adamdanishj30/washer-pdm/docs/hardware_guides/diagrams/washer_electronics_layout_diagram.jpg

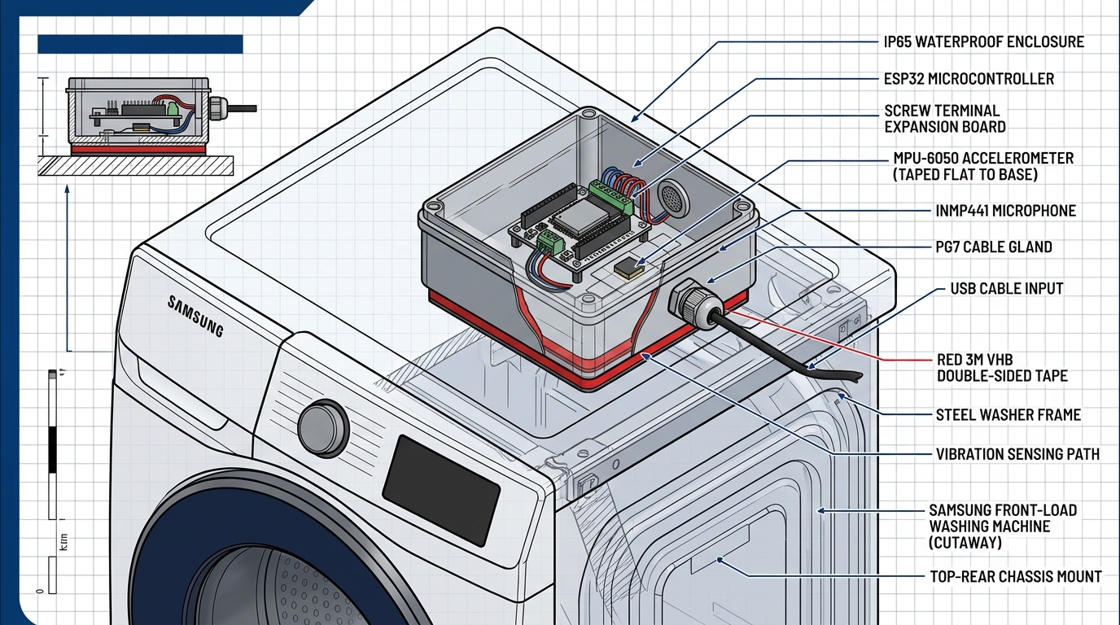
docs/hardware_guides/diagrams/washer_electronics_layout_diagram.jpg
