adamdanishj30/washer-pdm/docs/hardware_guides/diagrams/annotated_inmp441_pinout.png

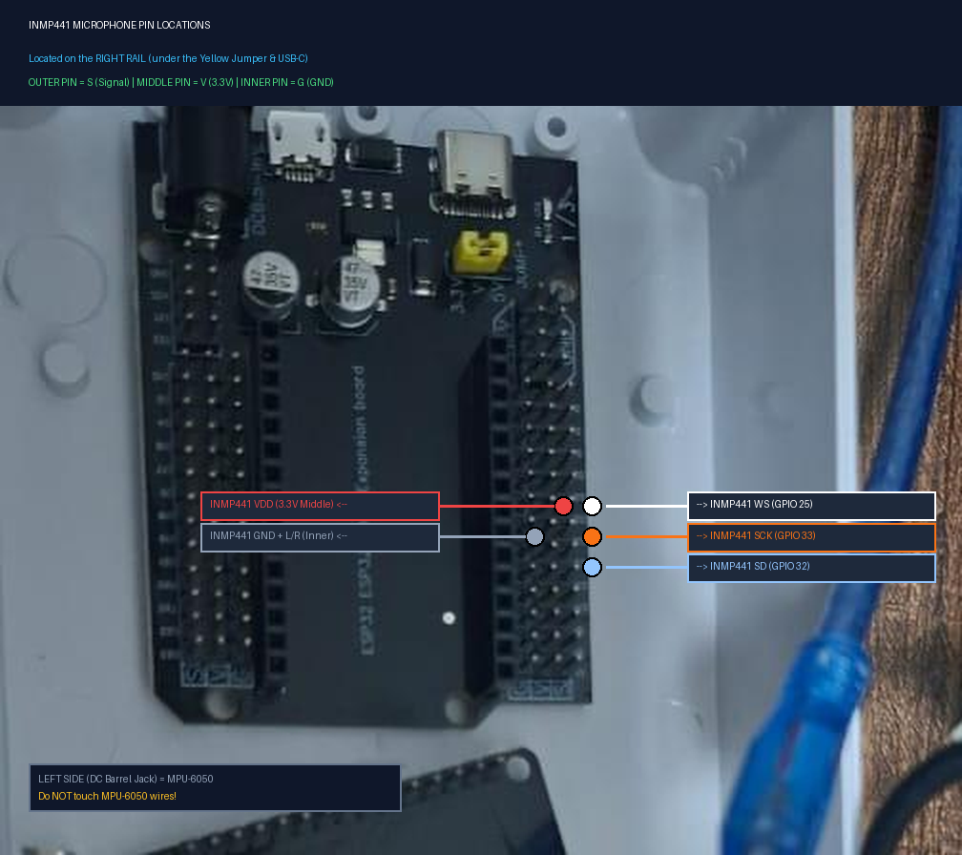
docs/hardware_guides/diagrams/annotated_inmp441_pinout.png
