adamdanishj30/washer-pdm/ml/models/loco_report.md

# Leave-one-cycle-out evaluation (nested, healthy baseline + injected faults)

Generated by `py ml/train_unsupervised_pdm.py`. Every number below comes from a model that never saw the cycle it was tested on (threshold and percentile tables included).

## Data caveats

- 8 healthy cycles, 6,461 windows of 5 s; effective sample size for cycle-level claims is 8, not 6,461 (consecutive windows are strongly correlated).
- SmartThings phase labels present on 0% of windows -> the model is NOT phase-conditioned (one pooled model for the whole cycle).
- Power unusable in 5/8 cycles (wash_cycle_2026-10-11_1019, wash_cycle_2026-10-12_1019, wash_cycle_2026-10-15_1020, wash_cycle_2026-10-15_morning, wash_cycle_2026-10-17_0835) -> power features excluded.
- Accelerometer gravity vector moved by up to 0.76 m/s^2 between cycles (sensor re-mounted/tilted) -> only orientation-independent vibration features are used.
- Legacy data = one instantaneous accel sample + one 8 ms audio RMS per 5 s. Impulsive (bearing) and spectral features cannot be computed; collect firmware-07 cycles.

## Healthy cycles: false alarms

| model | false-alarm cycles | 95% upper bound on false-alarm rate | healthy windows red | amber |
|---|---|---|---|---|
| mahalanobis | 0 / 8 | 31% | 0.3% | 4.88% |
| iforest | 0 / 8 | 31% | 0.49% | 4.59% |
| ocsvm | 1 / 8 | 47% | 0.35% | 3.77% |

The upper bound is wide because there are only a few cycles; it narrows only with more healthy cycles (about 30 alarm-free cycles are needed to claim < 10%).

## Injected faults: clean detection rate by severity

Clean detection = cycle alarm (overall model OR an indicator: 10-min EWMA of calibrated z above its threshold) after the fault started AND no alarm before it. Faults start halfway through the held-out cycle and ramp in over 3 minutes.

### mahalanobis

| fault | unit | sev 1 | sev 2 | sev 3 | sev 4 | min detectable |
|---|---|---|---|---|---|---|
| acoustic_rise | x RMS | 0.1: 12% (26.5 min) | 0.25: 12% (12.6 min) | 0.5: 25% (21.0 min) | 1: 88% (15.7 min) | 1.0 |
| vibration_rise | m/s2 RMS | 0.02: 0% | 0.05: 0% | 0.1: 0% | 0.2: 0% | not reached |

### iforest

| fault | unit | sev 1 | sev 2 | sev 3 | sev 4 | min detectable |
|---|---|---|---|---|---|---|
| acoustic_rise | x RMS | 0.1: 12% (26.5 min) | 0.25: 12% (12.6 min) | 0.5: 25% (21.0 min) | 1: 88% (15.7 min) | 1.0 |
| vibration_rise | m/s2 RMS | 0.02: 0% | 0.05: 0% | 0.1: 0% | 0.2: 0% | not reached |

### ocsvm

| fault | unit | sev 1 | sev 2 | sev 3 | sev 4 | min detectable |
|---|---|---|---|---|---|---|
| acoustic_rise | x RMS | 0.1: 12% (6.3 min) | 0.25: 12% (5.1 min) | 0.5: 25% (19.7 min) | 1: 88% (15.7 min) | 1.0 |
| vibration_rise | m/s2 RMS | 0.02: 12% (27.5 min) | 0.05: 0% | 0.1: 0% | 0.2: 0% | not reached |

## What these results do and do not show

- They show the false-alarm behaviour on the recorded healthy cycles and how large a sustained, physically-parameterised change must be before the pipeline reliably flags it.
- They do NOT show that real bearing or damper faults would be detected: injected faults are models (see `ml/fault_injection.py` for the limits), and no real fault data exists yet.
- Component labels (acoustic / vibration / power indicators) say where a deviation is, not which part failed. No remaining-useful-life estimate is made: that needs real degradation data.
