adamdanishj30/washer-pdm/ml/outputs/fw07_loco_2026-10-31/loco_report.md

# Leave-one-cycle-out evaluation (nested, healthy baseline + injected faults)

Generated by `py ml/train_unsupervised_pdm.py`. Every number below comes from a model that never saw the cycle it was tested on (threshold and percentile tables included).

## Data caveats

- 9 healthy cycles, 7,443 windows of 5 s; effective sample size for cycle-level claims is 9, not 7,443 (consecutive windows are strongly correlated).
- SmartThings phase labels present on 0% of windows -> the model is NOT phase-conditioned (one pooled model for the whole cycle).
- Accelerometer gravity vector moved by up to 15.46 m/s^2 between cycles (sensor re-mounted/tilted) -> only orientation-independent vibration features are used.

## Healthy cycles: false alarms

| model | false-alarm cycles | 95% upper bound on false-alarm rate | healthy windows red | amber |
|---|---|---|---|---|
| mahalanobis | 2 / 9 | 55% | 0.26% | 5.11% |
| iforest | 2 / 9 | 55% | 2.44% | 1.57% |
| ocsvm | 2 / 9 | 55% | 0.11% | 4.42% |

The upper bound is wide because there are only a few cycles; it narrows only with more healthy cycles (about 30 alarm-free cycles are needed to claim < 10%).

## Injected faults: clean detection rate by severity

Clean detection = cycle alarm (overall model OR an indicator: 10-min EWMA of calibrated z above its threshold) after the fault started AND no alarm before it. Faults start halfway through the held-out cycle and ramp in over 3 minutes.

### mahalanobis

| fault | unit | sev 1 | sev 2 | sev 3 | sev 4 | min detectable |
|---|---|---|---|---|---|---|
| power_drag | W | 5: 11% (36.2 min) | 10: 11% (36.2 min) | 20: 11% (36.2 min) | 40: 11% (36.2 min) | not reached |
| bearing_impulsive | x hp RMS | 0.1: 11% (36.2 min) | 0.25: 11% (36.2 min) | 0.5: 44% (19.7 min) | 1: 78% (7.5 min) | 1.0 |
| suspension_rocking | m/s2 RMS | 0.01: 11% (35.8 min) | 0.02: 11% (34.5 min) | 0.05: 11% (20.2 min) | 0.1: 44% (37.3 min) | not reached |
| imbalance_1x | m/s2 RMS | 0.02: 11% (36.2 min) | 0.05: 11% (33.0 min) | 0.1: 11% (18.9 min) | 0.2: 44% (26.2 min) | not reached |

### iforest

| fault | unit | sev 1 | sev 2 | sev 3 | sev 4 | min detectable |
|---|---|---|---|---|---|---|
| power_drag | W | 5: 11% (35.3 min) | 10: 11% (35.3 min) | 20: 11% (35.3 min) | 40: 11% (35.3 min) | not reached |
| bearing_impulsive | x hp RMS | 0.1: 11% (35.2 min) | 0.25: 11% (35.1 min) | 0.5: 44% (19.7 min) | 1: 78% (7.5 min) | 1.0 |
| suspension_rocking | m/s2 RMS | 0.01: 11% (35.2 min) | 0.02: 11% (34.5 min) | 0.05: 11% (20.2 min) | 0.1: 44% (37.3 min) | not reached |
| imbalance_1x | m/s2 RMS | 0.02: 11% (35.2 min) | 0.05: 11% (33.0 min) | 0.1: 11% (18.9 min) | 0.2: 44% (26.2 min) | not reached |

### ocsvm

| fault | unit | sev 1 | sev 2 | sev 3 | sev 4 | min detectable |
|---|---|---|---|---|---|---|
| power_drag | W | 5: 11% (36.2 min) | 10: 11% (36.2 min) | 20: 11% (36.2 min) | 40: 11% (36.2 min) | not reached |
| bearing_impulsive | x hp RMS | 0.1: 11% (36.2 min) | 0.25: 11% (36.2 min) | 0.5: 44% (19.7 min) | 1: 78% (7.5 min) | 1.0 |
| suspension_rocking | m/s2 RMS | 0.01: 11% (35.8 min) | 0.02: 11% (34.5 min) | 0.05: 11% (20.2 min) | 0.1: 44% (37.3 min) | not reached |
| imbalance_1x | m/s2 RMS | 0.02: 11% (36.2 min) | 0.05: 11% (33.0 min) | 0.1: 11% (18.9 min) | 0.2: 44% (26.2 min) | not reached |

## What these results do and do not show

- They show the false-alarm behaviour on the recorded healthy cycles and how large a sustained, physically-parameterised change must be before the pipeline reliably flags it.
- They do NOT show that real bearing or damper faults would be detected: injected faults are models (see `ml/fault_injection.py` for the limits), and no real fault data exists yet.
- Component labels (acoustic / vibration / power indicators) say where a deviation is, not which part failed. No remaining-useful-life estimate is made: that needs real degradation data.
