adamdanishj30/washer-pdm/docs/hardware_guides/diagrams/mic_mounting_visual_guide.png

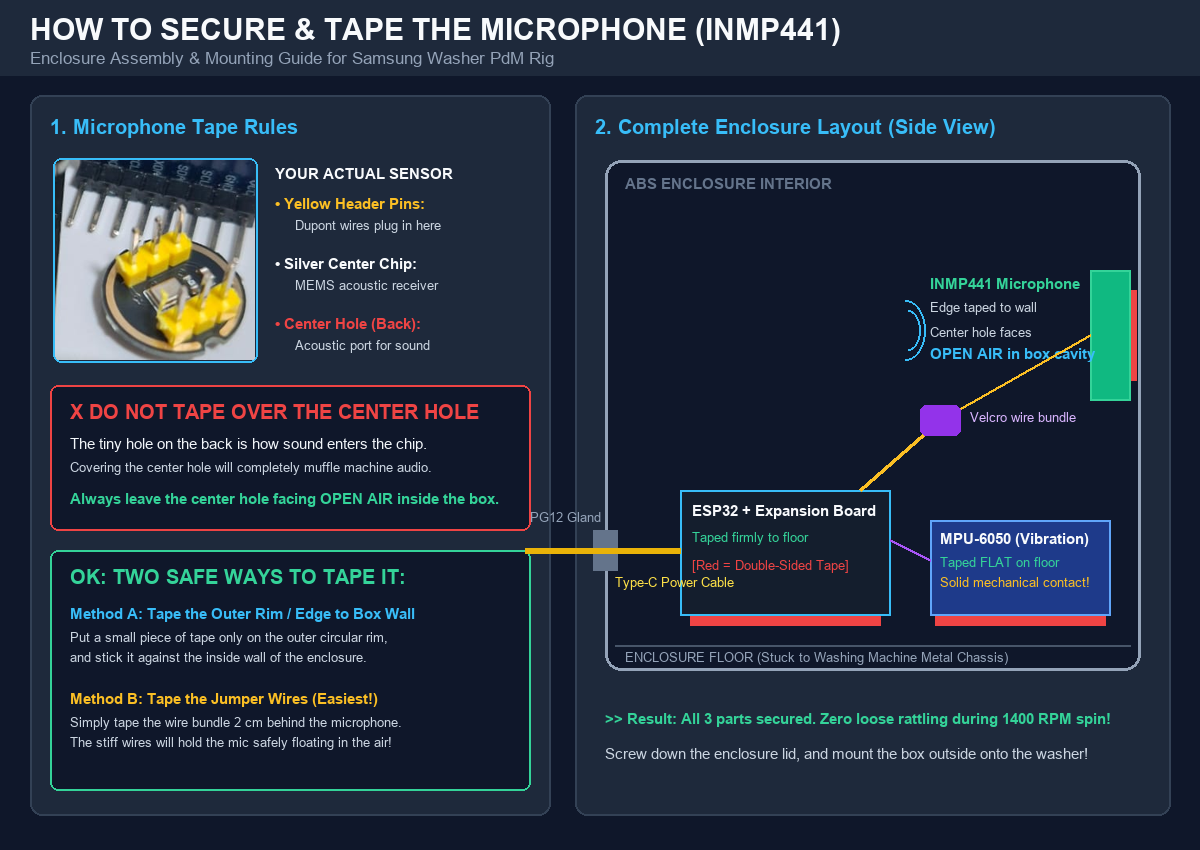
docs/hardware_guides/diagrams/mic_mounting_visual_guide.png
