adamdanishj30/washer-pdm/docs/hardware_guides/diagrams/mic_sides_clarity_guide.png

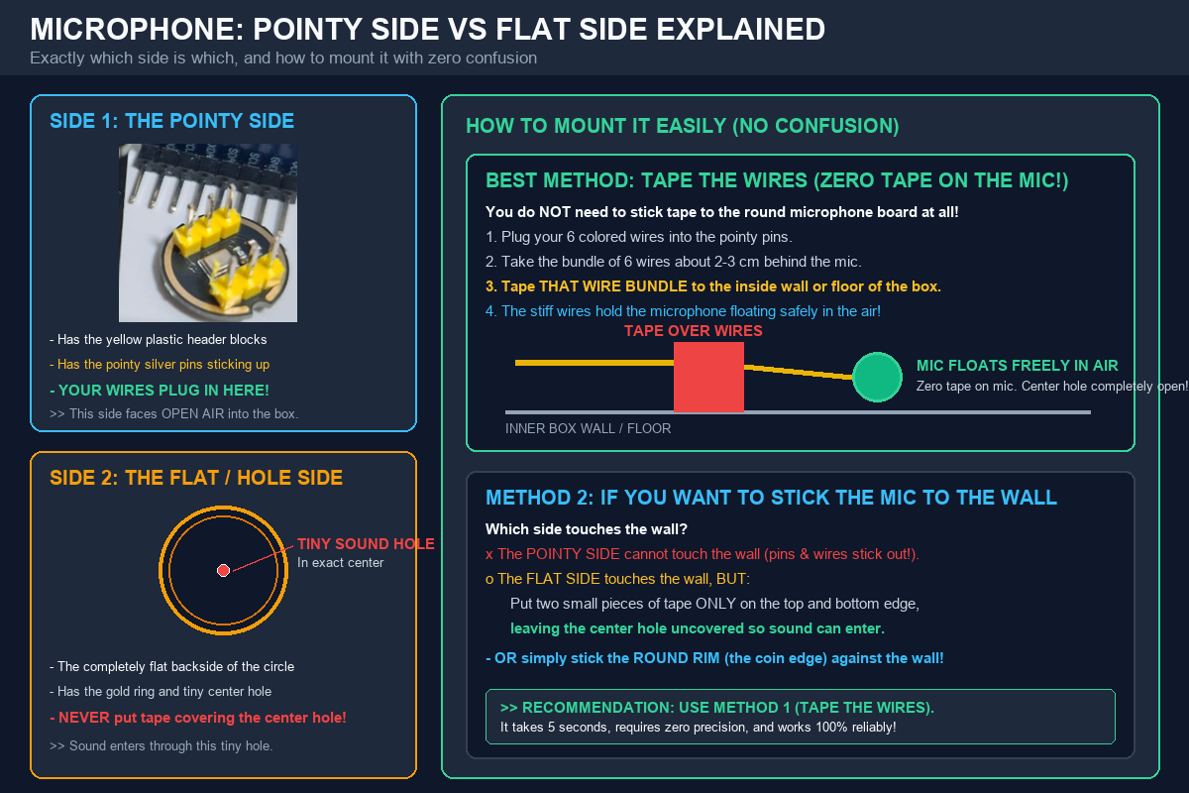
docs/hardware_guides/diagrams/mic_sides_clarity_guide.png
