adamdanishj30/washer-pdm/data/testing_data/wash_cycle_1009.csv

timestamp_ms | accel_x | accel_y | accel_z | audio_rms | power_w | phase | load_class
10278 | -1.78 | 2.20 | -9.18 | 62.3 | 0.0 | weightSensing | MEDIUM
15296 | -1.75 | 2.23 | -9.21 | 120.2 | 0.0 | weightSensing | MEDIUM
20386 | -1.75 | 2.23 | -9.17 | 297.5 | 0.0 | weightSensing | MEDIUM
25417 | -1.78 | 2.20 | -9.21 | 82.7 | 0.0 | weightSensing | MEDIUM
30506 | -1.70 | 2.27 | -9.28 | 407.4 | 0.0 | spin | MEDIUM
35510 | -1.80 | 2.22 | -9.17 | 203.6 | 0.0 | weightSensing | MEDIUM
40659 | -1.71 | 2.17 | -9.21 | 275.1 | 0.0 | weightSensing | MEDIUM
45693 | -1.71 | 2.29 | -9.14 | 80.1 | 0.0 | weightSensing | MEDIUM
50837 | -1.73 | 2.18 | -9.15 | 81.2 | 0.0 | weightSensing | MEDIUM
55851 | -1.75 | 2.24 | -9.20 | 193.9 | 0.0 | weightSensing | MEDIUM
60970 | -1.74 | 2.24 | -9.07 | 169.5 | 0.0 | weightSensing | MEDIUM
65990 | -1.77 | 2.21 | -9.12 | 180.2 | 0.0 | weightSensing | MEDIUM
71144 | -1.74 | 2.17 | -9.21 | 161.5 | 0.0 | weightSensing | MEDIUM
76156 | -1.72 | 2.22 | -9.09 | 57.5 | 0.0 | weightSensing | MEDIUM
81471 | -1.73 | 2.22 | -9.19 | 101.8 | 0.0 | weightSensing | MEDIUM
123113 | -1.76 | 2.15 | -9.15 | 295.1 | 0.0 | wash | MEDIUM
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
