adamdanishj30/washer-pdm/data/testing_data/wash_cycle_2026-10-11_1020.csv

timestamp_ms | accel_x | accel_y | accel_z | audio_rms | power_w
10681 | -1.51 | 2.62 | -9.1 | 157.7 | 0.0
15701 | -1.54 | 2.61 | -9.03 | 90.0 | 0.0
20822 | -1.57 | 2.59 | -9.06 | 234.6 | 0.0
25823 | -1.54 | 2.66 | -9.1 | 105.9 | 0.0
31506 | -1.56 | 2.61 | -9.13 | 156.4 | 0.0
36904 | -1.58 | 2.63 | -9.12 | 21.3 | 0.0
42076 | -1.55 | 2.59 | -9.13 | 216.5 | 0.0
53925 | -1.56 | 2.62 | -9.14 | 289.1 | 0.0
65528 | -1.57 | 2.6 | -9.05 | 247.6 | 0.0
70933 | -1.57 | 2.66 | -9.13 | 32.6 | 0.0
