adamdanishj30/washer-pdm/data/testing_data/wash_cycle_2026-10-12_0800.csv

timestamp_ms | accel_x | accel_y | accel_z | audio_rms | power_w | phase | load_class
9744 | -1.37 | 2.55 | -9.09 | 79.4 | 0.0 | weightSensing | MEDIUM
16463 | -1.32 | 2.57 | -9.19 | 69.5 | 0.0 | weightSensing | MEDIUM
21509 | -1.40 | 2.56 | -9.18 | 144.6 | 0.0 | weightSensing | MEDIUM
26557 | -1.37 | 2.58 | -9.14 | 87.0 | 0.0 | weightSensing | MEDIUM
31591 | -1.34 | 2.61 | -9.17 | 99.9 | 0.0 | weightSensing | MEDIUM
36616 | -1.35 | 2.58 | -9.18 | 104.5 | 0.0 | weightSensing | MEDIUM
41692 | -1.34 | 2.56 | -9.13 | 71.0 | 0.0 | weightSensing | MEDIUM
46729 | -1.35 | 2.60 | -9.14 | 102.6 | 0.0 | weightSensing | MEDIUM
51816 | -1.36 | 2.56 | -9.16 | 169.6 | 0.0 | weightSensing | MEDIUM
56821 | -1.35 | 2.60 | -9.17 | 59.2 | 0.0 | weightSensing | MEDIUM
61893 | -1.32 | 2.60 | -9.15 | 82.6 | 0.0 | weightSensing | MEDIUM
66905 | -1.35 | 2.60 | -9.16 | 77.1 | 0.0 | weightSensing | MEDIUM
72050 | -1.35 | 2.58 | -9.18 | 110.6 | 0.0 | weightSensing | MEDIUM
77091 | -1.34 | 2.60 | -9.13 | 150.2 | 0.0 | weightSensing | MEDIUM
82144 | -1.35 | 2.58 | -9.10 | 143.3 | 0.0 | weightSensing | MEDIUM
87180 | -1.36 | 2.58 | -9.17 | 162.5 | 0.0 | weightSensing | MEDIUM
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
