adamdanishj30/washer-pdm/data/testing_data/wash_cycle_2026-10-12_1009.csv

timestamp_ms | accel_x | accel_y | accel_z | audio_rms | power_w
10278 | -1.78 | 2.20 | -9.18 | 62.3 | 0.0
15296 | -1.75 | 2.23 | -9.21 | 120.2 | 0.0
20386 | -1.75 | 2.23 | -9.17 | 297.5 | 0.0
25417 | -1.78 | 2.20 | -9.21 | 82.7 | 0.0
30506 | -1.70 | 2.27 | -9.28 | 407.4 | 0.0
35510 | -1.80 | 2.22 | -9.17 | 203.6 | 0.0
40659 | -1.71 | 2.17 | -9.21 | 275.1 | 0.0
45693 | -1.71 | 2.29 | -9.14 | 80.1 | 0.0
50837 | -1.73 | 2.18 | -9.15 | 81.2 | 0.0
55851 | -1.75 | 2.24 | -9.20 | 193.9 | 0.0
60970 | -1.74 | 2.24 | -9.07 | 169.5 | 0.0
65990 | -1.77 | 2.21 | -9.12 | 180.2 | 0.0
71144 | -1.74 | 2.17 | -9.21 | 161.5 | 0.0
76156 | -1.72 | 2.22 | -9.09 | 57.5 | 0.0
81471 | -1.73 | 2.22 | -9.19 | 101.8 | 0.0
123113 | -1.76 | 2.15 | -9.15 | 295.1 | 0.0
128122 | -1.78 | 2.17 | -9.21 | 71.7 | 0.0
133132 | -1.75 | 2.19 | -9.16 | 164.2 | 0.0
138133 | -1.75 | 2.14 | -9.16 | 91.5 | 0.0
148584 | -1.71 | 2.16 | -9.19 | 42.1 | 0.0
153621 | -1.72 | 2.14 | -9.11 | 139.7 | 0.0
158796 | -1.71 | 2.20 | -9.19 | 200.7 | 0.0
163818 | -1.76 | 2.13 | -9.10 | 123.3 | 0.0
172631 | -1.72 | 2.18 | -9.18 | 38.7 | 0.0
177681 | -1.75 | 2.22 | -9.17 | 128.8 | 0.0
235398 | -1.76 | 2.17 | -9.21 | 46.3 | 0.0
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
