adamdanishj30/washer-pdm/generate_proposal_pdf.py

import os
import subprocess
import sys
import base64

def get_base64_image(path):
    if os.path.exists(path):
        with open(path, "rb") as f:
            ext = os.path.splitext(path)[1].lower().replace('.', '')
            if ext == 'jpg': ext = 'jpeg'
            return f"data:image/{ext};base64," + base64.b64encode(f.read()).decode('utf-8')
    return None

def main():
    base_dir = os.path.dirname(os.path.abspath(__file__))
    html_path = os.path.join(base_dir, "proposal_presentation.html")
    pdf_path = os.path.join(base_dir, "PROPOSAL_AcuVibe_PdM_Township_of_Tomorrow.pdf")

    # Load images if available
    img_layout = get_base64_image(os.path.join(base_dir, "washer_electronics_layout_diagram.jpg"))
    img_prototype = get_base64_image(os.path.join(base_dir, "image", "items.jpeg"))
    img_pinout = get_base64_image(os.path.join(base_dir, "annotated_inmp441_pinout.png"))

    html_content = f"""<!DOCTYPE html>
<html lang="en">
<head>
<meta charset="UTF-8">
<title>AcuVibe PdM - Sime Darby Property Hackathon Proposal</title>
<style>
  @import url('https://fonts.googleapis.com/css2?family=Plus+Jakarta+Sans:wght@300;400;500;600;700;800&family=JetBrains+Mono:wght@400;500;600&display=swap');

  @page {{
    size: A4;
    margin: 14mm 14mm 14mm 14mm;
  }}

  * {{
    box-sizing: border-box;
    -webkit-print-color-adjust: exact !important;
    print-color-adjust: exact !important;
  }}

  body {{
    font-family: 'Plus Jakarta Sans', -apple-system, BlinkMacSystemFont, "Segoe UI", Roboto, sans-serif;
    color: #1e293b;
    background-color: #ffffff;
    line-height: 1.55;
    font-size: 9.5pt;
    margin: 0;
    padding: 0;
  }}

  /* Page Break Utilities */
  .page-break {{
    page-break-before: always;
  }}
  .avoid-break {{
    page-break-inside: avoid;
  }}

  /* Cover Page Styling */
  .cover-container {{
    min-height: 255mm;
    display: flex;
    flex-direction: column;
    justify-content: space-between;
    padding: 10mm 5mm;
    border: 1px solid #e2e8f0;
    border-radius: 12px;
    background: linear-gradient(145deg, #f8fafc 0%, #ffffff 60%, #f0fdf4 100%);
    position: relative;
    overflow: hidden;
  }}

  .cover-header {{
    border-bottom: 2px solid #0f172a;
    padding-bottom: 8mm;
  }}

  .competition-badge {{
    display: inline-block;
    background: #0f172a;
    color: #38bdf8;
    font-size: 8pt;
    font-weight: 700;
    text-transform: uppercase;
    letter-spacing: 1.2px;
    padding: 4px 12px;
    border-radius: 20px;
    margin-bottom: 12px;
  }}

  .track-badge {{
    display: inline-block;
    background: #dcfce7;
    color: #166534;
    border: 1px solid #86efac;
    font-size: 8pt;
    font-weight: 700;
    text-transform: uppercase;
    letter-spacing: 0.8px;
    padding: 4px 10px;
    border-radius: 20px;
    margin-left: 6px;
  }}

  .cover-title {{
    font-size: 24pt;
    font-weight: 800;
    color: #0f172a;
    line-height: 1.15;
    margin: 10px 0 6px 0;
  }}

  .cover-subtitle {{
    font-size: 13pt;
    font-weight: 600;
    color: #0284c7;
    margin: 0 0 14px 0;
  }}

  .theme-box {{
    background: #ffffff;
    border-left: 4px solid #0284c7;
    padding: 10px 14px;
    border-radius: 6px;
    box-shadow: 0 2px 6px rgba(0,0,0,0.04);
    font-style: italic;
    color: #334155;
    font-size: 9pt;
  }}

  .cover-highlights {{
    display: grid;
    grid-template-columns: repeat(3, 1fr);
    gap: 12px;
    margin: 20px 0;
  }}

  .highlight-card {{
    background: #ffffff;
    border: 1px solid #e2e8f0;
    border-radius: 8px;
    padding: 12px;
    box-shadow: 0 2px 4px rgba(0,0,0,0.02);
  }}

  .highlight-card h4 {{
    margin: 0 0 4px 0;
    font-size: 9pt;
    color: #64748b;
    text-transform: uppercase;
    letter-spacing: 0.5px;
  }}

  .highlight-card .stat {{
    font-size: 16pt;
    font-weight: 800;
    color: #0f172a;
    margin: 0;
  }}

  .highlight-card .stat-desc {{
    font-size: 8pt;
    color: #059669;
    font-weight: 600;
    margin-top: 2px;
  }}

  .cover-footer {{
    border-top: 1px solid #e2e8f0;
    padding-top: 8mm;
    display: flex;
    justify-content: space-between;
    align-items: flex-end;
    font-size: 8.5pt;
    color: #64748b;
  }}

  .live-pill {{
    background: #0f172a;
    color: #ffffff;
    padding: 8px 16px;
    border-radius: 8px;
    font-family: 'JetBrains Mono', monospace;
    font-size: 8.5pt;
    text-decoration: none;
    display: inline-block;
  }}
  .live-pill span {{
    color: #38bdf8;
    font-weight: 700;
  }}

  /* Typography */
  h1, h2, h3, h4 {{
    color: #0f172a;
    font-weight: 700;
  }}

  h1.section-header {{
    font-size: 15pt;
    border-bottom: 2px solid #0284c7;
    padding-bottom: 4px;
    margin-top: 18px;
    margin-bottom: 12px;
    display: flex;
    justify-content: space-between;
    align-items: center;
  }}

  h2.part-header {{
    font-size: 18pt;
    background: #0f172a;
    color: #ffffff;
    padding: 8px 14px;
    border-radius: 6px;
    margin-top: 0;
    margin-bottom: 14px;
    letter-spacing: 0.5px;
  }}

  h3 {{
    font-size: 11pt;
    margin-top: 12px;
    margin-bottom: 6px;
    color: #0369a1;
  }}

  p {{
    margin: 0 0 8px 0;
    text-align: justify;
  }}

  /* Tables */
  table {{
    width: 100%;
    border-collapse: collapse;
    margin: 10px 0 14px 0;
    font-size: 8.5pt;
  }}

  th {{
    background: #0f172a;
    color: #ffffff;
    font-weight: 600;
    text-align: left;
    padding: 6px 10px;
    border: 1px solid #0f172a;
  }}

  td {{
    padding: 6px 10px;
    border: 1px solid #cbd5e1;
    vertical-align: top;
  }}

  tr:nth-child(even) {{
    background-color: #f8fafc;
  }}

  /* Alert & Callout Boxes */
  .callout {{
    border-left: 4px solid #0284c7;
    background: #f0f9ff;
    padding: 8px 12px;
    margin: 10px 0;
    border-radius: 0 6px 6px 0;
    font-size: 9pt;
  }}

  .callout.green {{
    border-left-color: #059669;
    background: #f0fdf4;
  }}

  .callout.amber {{
    border-left-color: #d97706;
    background: #fffbeb;
  }}

  .callout-title {{
    font-weight: 700;
    margin-bottom: 3px;
    color: #0f172a;
  }}

  /* Diagrams & Monospace blocks */
  pre, code {{
    font-family: 'JetBrains Mono', monospace;
  }}

  .diagram-box {{
    background: #0f172a;
    color: #38bdf8;
    padding: 10px 14px;
    border-radius: 8px;
    font-size: 7.5pt;
    line-height: 1.35;
    margin: 10px 0;
    overflow: hidden;
  }}

  /* Pitch Deck Cards */
  .slide-card {{
    border: 1px solid #cbd5e1;
    border-radius: 8px;
    background: #ffffff;
    padding: 10px 14px;
    margin-bottom: 12px;
    box-shadow: 0 1px 3px rgba(0,0,0,0.03);
    page-break-inside: avoid;
  }}

  .slide-header {{
    display: flex;
    justify-content: space-between;
    align-items: center;
    border-bottom: 1px solid #e2e8f0;
    padding-bottom: 4px;
    margin-bottom: 6px;
  }}

  .slide-num {{
    background: #0284c7;
    color: #ffffff;
    font-weight: 700;
    font-size: 8pt;
    padding: 2px 8px;
    border-radius: 4px;
  }}

  .slide-title {{
    font-size: 10.5pt;
    font-weight: 700;
    color: #0f172a;
  }}

  .script-box {{
    background: #f8fafc;
    border-left: 3px solid #64748b;
    padding: 6px 10px;
    font-size: 8.5pt;
    font-style: italic;
    color: #334155;
    margin-top: 6px;
  }}

  .img-showcase {{
    display: flex;
    gap: 12px;
    margin: 10px 0;
  }}

  .img-showcase img {{
    max-height: 52mm;
    border-radius: 6px;
    border: 1px solid #cbd5e1;
  }}

  .badge {{
    display: inline-block;
    padding: 2px 6px;
    border-radius: 4px;
    font-size: 7.5pt;
    font-weight: 700;
  }}
  .badge-green {{ background: #dcfce7; color: #15803d; }}
  .badge-blue {{ background: #e0f2fe; color: #0369a1; }}
  .badge-amber {{ background: #fef3c7; color: #b45309; }}

</style>
</head>
<body>

<!-- COVER PAGE -->
<div class="cover-container">
  <div class="cover-header">
    <div>
      <span class="competition-badge">Sime Darby Property University Hackathon</span>
      <span class="track-badge">Track: PLANET (Circular Economy & Energy)</span>
      <span class="track-badge" style="background:#e0f2fe; color:#0369a1; border-color:#7dd3fc;">Synergy: PEOPLE (Digital Living)</span>
    </div>
    <div class="cover-title">AcuVibe PdM: Multimodal Predictive Maintenance for Sustainable Townships</div>
    <div class="cover-subtitle">From Home Appliances to Township Infrastructure: Value Multiplying Electromechanical Asset Health</div>
    
    <div class="theme-box">
      <strong>Theme:</strong> "How might we value multiply the Township of Tomorrow where people, businesses, economies and planet thrive together through innovation, technology and sustainable living?"
    </div>
  </div>

  <div class="cover-highlights">
    <div class="highlight-card">
      <h4>Energy Efficiency</h4>
      <div class="stat">15% – 35%</div>
      <div class="stat-desc">Friction Drag Eliminated</div>
    </div>
    <div class="highlight-card">
      <h4>Circular Lifespan</h4>
      <div class="stat">+5 to 10 Yrs</div>
      <div class="stat-desc">Asset Longevity Multiplier</div>
    </div>
    <div class="highlight-card">
      <h4>Commercial ROI</h4>
      <div class="stat">&lt; 3 Months</div>
      <div class="stat-desc">Full Capital Payback Period</div>
    </div>
  </div>

  <div style="font-size:9pt; color:#334155; line-height:1.6;">
    <p><strong>Target Pilot Township:</strong> City of Elmina (Masjid Elmina, Elmina Lakeside Mall, Clubhouses & Pumping Stations)<br>
    <strong>Core Technology:</strong> Dual-Core ESP32 Edge Computing + MPU-6050 Kinematics + INMP441 I2S Acoustics + Tapo P110 Power + SmartThings AI State Engine<br>
    <strong>Empirical Evidence in Hand:</strong> Operating physical testbed rig, 5,530+ verified real operational telemetry points, 6 archived full wash sessions, and active global Cloudflare dashboard.</p>
  </div>

  <div class="cover-footer">
    <div>
      <strong>Submitted by:</strong> Predictive Maintenance & Smart Township Engineering Team<br>
      <strong>Partner Platform:</strong> Kolaxus Innovation Network &nbsp;|&nbsp; <strong>Date:</strong> October 2026
    </div>
    <div>
      <div class="live-pill">LIVE RIG: <span>https://washer-pdm.pages.dev</span></div>
    </div>
  </div>
</div>

<div class="page-break"></div>

<!-- PART 1: THE EXECUTIVE DOSSIER -->
<h2 class="part-header">Part 1: The Executive Competition Dossier</h2>

<h1 class="section-header">1. Executive Summary & Strategic Positioning</h1>
<p>In modern sustainable townships—such as Sime Darby Property’s <strong>City of Elmina</strong>, <strong>Bandar Bukit Raja</strong>, and <strong>KL East</strong>—mechanical equipment operates continuously. From commercial central air-conditioning chillers in community mosques and retail centers to domestic washing machines and stormwater drainage pumps, thousands of rotating electromechanical assets power daily living.</p>

<p>Today, nearly all of this machinery is managed via <strong>reactive "run-to-failure" maintenance</strong> or arbitrary calendar rounds. When mechanical wear starts:</p>
<ul>
  <li><strong>The Parasitic Energy Leech:</strong> Unlubricated bearings and fatigued dampers create friction. Modern inverter-driven motors automatically pull <strong>15% to 35% excess electrical wattage</strong> to maintain speed, completely undetected by conventional circuit breakers for months.</li>
  <li><strong>Catastrophic Disruption:</strong> Minor RM 25 component degradation cascades into motor burnout or compressor seizure (costing RM 800–RM 1,800+ for appliances, and RM 15,000–RM 50,000+ for commercial chillers).</li>
  <li><strong>Severe Landfill E-Waste:</strong> 70 kg appliances and multi-ton industrial compressors are scrapped into landfills simply because a single consumable wear component failed unnoticed.</li>
</ul>

<div class="callout green">
  <div class="callout-title">The "Option 2" Winning Positioning</div>
  Rather than presenting an unverified concept, <strong>AcuVibe PdM</strong> pairs a <strong>field-tested physical testbed</strong> (deployed on a high-vibration Samsung front-load washer) with a <strong>scalable township infrastructure platform</strong>. The physical failure physics (vibration harmonics &rarr; acoustic friction &rarr; parasitic power drag &rarr; breakdown) is identical across home appliances and commercial township chillers.
</div>

<div class="diagram-box">
+---------------------------------------------------------------------------------------------------------+
|                                    THE TOWNSHIP PDM ARCHITECTURE                                        |
|                                                                                                         |
|   [ MICRO: The Proven Testbed ]                              [ MACRO: The Township Vision ]             |
|   • Home Appliance (Samsung Washer)                          • Community Mosques, Suraus & Clubhouses   |
|   • Dual-core ESP32 FreeRTOS Edge Processing                 • Commercial Malls & Retail Hubs           |
|   • Kinematics + Acoustics + Tapo P110 Power                 • Township Water Booster & Drainage Pumps  |
|   • 5,530+ Real Data Points & Live Web Dashboard             • 20–30+ Centralized Commercial Chillers   |
+---------------------------------------------------------------------------------------------------------+
</div>

<h1 class="section-header">2. Sime Darby Property Hackathon Alignment Matrix</h1>
<table>
  <tr>
    <th style="width:20%;">Hackathon Track</th>
    <th style="width:25%;">Specific Criterion</th>
    <th style="width:35%;">Township Impact</th>
    <th style="width:20%;">Quantifiable KPI</th>
  </tr>
  <tr>
    <td><span class="badge badge-green">PLANET (Primary)</span></td>
    <td><strong>02 Circular Economy</strong><br>(Reuse, don't waste)</td>
    <td>Intervenes at <strong>Point P on the P-F Interval</strong> to replace RM 25–50 consumable wear parts before catastrophic motor/compressor seizure occurs.</td>
    <td><strong>+5 to 10 years</strong> asset lifespan;<br><strong>70 kg</strong> e-waste prevented/unit.</td>
  </tr>
  <tr>
    <td><span class="badge badge-green">PLANET (Primary)</span></td>
    <td><strong>03 Energy Efficiency</strong></td>
    <td>Continuously detects and eliminates <strong>parasitic friction drag</strong> (+15% to +35% excess wattage), lowering commercial grid demand and residential utility bills.</td>
    <td><strong>15% to 35%</strong> motor energy waste eliminated across township.</td>
  </tr>
  <tr>
    <td><span class="badge badge-blue">PEOPLE (Synergy)</span></td>
    <td><strong>05 Digital Living</strong></td>
    <td>Replaces stressful emergency breakdowns with continuous <strong>Machine Health Index (0%–100%)</strong> and RUL mobile transparency for residents and automated triage for facility managers.</td>
    <td><strong>100%</strong> breakdown transparency;<br><strong>70%</strong> inspection time cut.</td>
  </tr>
  <tr>
    <td><span class="badge badge-amber">BUSINESS / OPEX</span></td>
    <td><strong>Value Multiplication</strong></td>
    <td>Replaces manual 1-by-1 physical walk-throughs of 30+ commercial HVAC units with automated, condition-based maintenance dispatching.</td>
    <td><strong>&lt; 3 months</strong> capital payback period per cluster.</td>
  </tr>
</table>

<h1 class="section-header">3. Physical Science & Economic Reality of Machine Degradation</h1>
<p>Universal electromechanical degradation follows a deterministic physical chain:</p>
<p style="text-align:center; font-weight:700; color:#0369a1; font-size:10.5pt;">
  Micro-Vibration Harmonics &rarr; Acoustic Friction &rarr; Parasitic Electrical Drag &rarr; Catastrophic Breakdown
</p>

<div class="callout amber avoid-break">
  <div class="callout-title">The P-F Interval Economic Equation</div>
  Traditional maintenance waits until Point F (functional failure). AcuVibe PdM operates at Point P (potential failure detection):<br>
  <strong>Value Equation:</strong> Preventative Component Fix (RM 25–50) &ll; Catastrophic Replacement (RM 1,500–50,000+) + 15–35% Cumulative Energy Leeching
</div>

<div class="page-break"></div>

<h1 class="section-header">4. End-to-End System Architecture & Dual-Core Discipline</h1>
<p>The platform architecture spans four tightly coupled tiers: Physical Edge Sensing, High-Reliability Dual-Core Firmware, Cloud Streaming Infrastructure, and Machine Learning Prognostics.</p>

<div class="avoid-break">
  <h3>4.1 The Physical Micro-Testbed Rig (Empirical Proof & Mass-Production Bridge)</h3>
  <p>To prove that multimodal predictive maintenance is genuinely feasible rather than purely theoretical, the AcuVibe architecture was physically built, packaged into an IP65 industrial enclosure, and deployed on an active <strong>Samsung WW10TP44DSX front-load washing machine</strong>:</p>
  <ul>
    <li><strong>The High-Stress Testbed Rationale:</strong> A washing machine drum spinning at 1,400 RPM with wet laundry is one of the most mechanically turbulent, violently vibrating, and acoustically noisy rotating systems in existence. If our sub-RM 50 sensor pod can reliably isolate micro-vibrations, acoustic friction, and motor wattage here without triggering false alarms, transferring this exact sensor pod to stationary commercial HVAC chillers and water pumps in mosques or malls is mechanically simpler, more stable, and virtually risk-free.</li>
    <li><strong>Proven Real-Time Data Pipeline:</strong> The physical rig actively captures, computes, and streams 3-axis kinematics (50 Hz), 24-bit acoustics (16 kHz), and motor wattage (1 Hz) in real time to Google Firebase, validated by <strong>over 5,530 verified real operational data points</strong>.</li>
  </ul>

  <div style="display: grid; grid-template-columns: 1.25fr 0.75fr; gap: 10px; margin: 8px 0;">
    <div style="border: 1px solid #cbd5e1; border-radius: 6px; padding: 6px; background: #f8fafc; text-align: center;">
      <img src="{img_layout}" style="width: 100%; max-height: 48mm; object-fit: contain; border-radius: 4px;">
      <div style="font-size: 7.2pt; font-weight: 600; color: #475569; margin-top: 3px;">Figure 4.1: Engineering Cutaway Diagram &mdash; Chassis Mounting, Sensors & VHB Coupling</div>
    </div>
    <div style="border: 1px solid #cbd5e1; border-radius: 6px; padding: 6px; background: #f8fafc; text-align: center;">
      <img src="{img_prototype}" style="width: 100%; max-height: 48mm; object-fit: contain; border-radius: 4px;">
      <div style="font-size: 7.2pt; font-weight: 600; color: #475569; margin-top: 3px;">Figure 4.2: Assembled Physical Hardware Rig in IP65 Pod</div>
    </div>
  </div>
</div>

<div class="avoid-break" style="margin-top: 6px;">
  <h3>4.2 FreeRTOS Dual-Core Discipline & Hardware Safety Guard</h3>
  <p>To eliminate thread contention, audio buffer under-runs, or network jitter, our custom C++ firmware enforces strict hardware processor isolation:</p>
  <ul>
    <li><strong>Core 1 (Real-Time Sensor DSP Engine):</strong> Dedicated strictly to continuous 50 Hz MPU-6050 I2C register burst reading and 16 kHz INMP441 I2S DMA buffer acquisition. RMS sound energy is computed in real time using 24-bit bitshift filtering. Thread-safe updates are guarded with <code>portMUX_TYPE</code> spinlocks.</li>
    <li><strong>Core 0 (Network & Protocol Engine):</strong> Handles Wi-Fi 802.11 b/g/n, Tapo P110 local encrypted KLAP queries (1 Hz), HTTPS Firebase uploads, and wireless ArduinoOTA updates.</li>
    <li><strong>Hardware Force-ON Watchdog Guard:</strong> Background watchdog polls smart plug relay state every 1.0s. If accidentally switched off, it immediately re-engages the relay within 1,000ms.</li>
  </ul>
</div>

<div class="avoid-break" style="margin-top: 6px;">
  <h3>4.3 Edge Telemetry Packaging & Dual-Tier Streaming Protocol</h3>
  <p>To bridge high-speed physical sensors with cloud analytics without latency or sample loss, the firmware formats telemetry into a standardized, lightweight JSON envelope guarded by spinlocks:</p>
  <div class="diagram-box" style="font-size: 7pt; line-height: 1.25; padding: 6px 10px; margin: 4px 0;">
&#123;
  "ts": &#123; ".sv": "timestamp" &#125;, "session": "wash_2026-10-16_085721",
  "ax": -0.12, "ay": 0.35, "az": 9.78, "vibe_mag": 9.82, "audio_rms": 248.5,
  "state": "RUNNING", "cnt": 1420, "uptime": 142
&#125;
  </div>
  <ul>
    <li><strong>Dual-Tier Transmission:</strong> Core 0 executes a <strong>1 Hz Hot Path</strong> (HTTPS PUT to Firebase <code>/live.json</code>) powering the real-time operator HUD with &lt;1s latency, and a <strong>5.0s Cold Path</strong> archiving batches to <code>/sessions/&lt;id&gt;/</code> for long-term ML training and Remaining Useful Life (RUL) regression.</li>
    <li><strong>Local High-Speed Fail-Safe:</strong> Concurrently broadcasts 50 Hz kinematic frames over local UDP port 5005, ensuring on-site technician diagnostics if WAN drops.</li>
  </ul>
</div>

<div class="avoid-break" style="margin-top: 6px;">
  <h3>4.4 Hardware Bill of Materials (BOM)</h3>
<table>
  <tr>
    <th>Component</th>
    <th>Specification / Variant</th>
    <th>Hardware Role</th>
    <th>Pilot Cost (MYR)</th>
  </tr>
  <tr>
    <td><strong>Microcontroller</strong></td>
    <td>NodeMCU ESP32 (30-Pin, 240 MHz Dual-Core)</td>
    <td>DSP acquisition, edge RMS calculation, and Wi-Fi streaming.</td>
    <td>RM 32.90</td>
  </tr>
  <tr>
    <td><strong>Expansion Shield</strong></td>
    <td>ESP32 Screw Terminal Shield</td>
    <td>High-vibration wire clamping, surviving 1,400 RPM spin.</td>
    <td>RM 8.46</td>
  </tr>
  <tr>
    <td><strong>Kinematics Sensor</strong></td>
    <td>MPU-6050 6-DOF Accelerometer</td>
    <td>High-speed 3-axis digital kinematics (&plusmn;16g @ 50 Hz).</td>
    <td>RM 21.99</td>
  </tr>
  <tr>
    <td><strong>Acoustic Sensor</strong></td>
    <td>INMP441 Omnidirectional MEMS Mic</td>
    <td>24-bit I2S digital DMA audio capturing friction squeal.</td>
    <td>RM 25.99</td>
  </tr>
  <tr>
    <td><strong>Power Monitor</strong></td>
    <td>TP-Link Tapo P110 (BS 1363 UK Type G)</td>
    <td>13A / 2,990W certified active power (W, V, mA @ 1 Hz).</td>
    <td>RM 45.00</td>
  </tr>
  <tr>
    <td><strong>Industrial Enclosure</strong></td>
    <td>ABS IP65 Junction Box (158x90x60mm)</td>
    <td>Weatherproofing; flat base provides solid structural coupling.</td>
    <td>RM 16.30</td>
  </tr>
  <tr>
    <td><strong>Coupling & Seals</strong></td>
    <td>3M VHB Tape + PG7 Cable Glands</td>
    <td>Viscoelastic mechanical bonding & watertight seal.</td>
    <td>RM 17.11</td>
  </tr>
  <tr style="font-weight:700; background:#f1f5f9;">
    <td colspan="3">Turnkey Pilot Kit Total (At commercial mass-production: &lt; RM 50 / pod)</td>
    <td>RM 170.95</td>
  </tr>
</table>
</div>

<div class="page-break"></div>

<h1 class="section-header">5. Proven Operational Datasets & Machine Learning Pipeline</h1>
<div class="avoid-break">
  <p>The system is verified on real-world operational datasets archived in the project repository:</p>
  <ul>
    <li><strong>3,980+ Clean Standardized Active Wash Telemetry Points:</strong> Formatted in <code>data/pdm_ml_standardized_training_dataset.csv</code>.</li>
    <li><strong>5 Genuine Archived Wash Cycles:</strong> Multi-minute and 100-minute cycles including <code>wash_cycle_2026-10-12_1019.csv</code> (1,216 records), <code>wash_cycle_2026-10-15_morning.csv</code> (1,216 records), and <code>wash_cycle_2026-10-16_0857.csv</code> (859 records with live Tapo power). Bench & idle traces are segregated in <code>data/testing_data/</code>.</li>
    <li><strong>Solving the Spin-Cycle Paradox:</strong> By fusing Samsung SmartThings ground-truth operational states (<code>washerJobState</code>), AcuVibe dynamically conditions anomaly thresholds, eliminating false alarms during normal 1,400 RPM spin extraction.</li>
  </ul>
</div>

<table>
  <tr>
    <th>Category</th>
    <th>Features</th>
    <th>Physical Units</th>
    <th>Diagnostic Significance</th>
  </tr>
  <tr>
    <td><strong>1. Kinematics</strong></td>
    <td>accel_x, accel_y, accel_z, vibe_mag</td>
    <td>m/s&sup2;</td>
    <td>Chassis rocking, damper shock, and drum spider fatigue.</td>
  </tr>
  <tr>
    <td><strong>2. Acoustics</strong></td>
    <td>audio_rms, audio_rms_db, anomaly_pct</td>
    <td>Canonical RMS, dB</td>
    <td>Bearing micro-spall, surface friction, and cavitation.</td>
  </tr>
  <tr>
    <td><strong>3. Electrical Power</strong></td>
    <td>power_w, voltage_v, current_ma, energy_wh</td>
    <td>W, V, mA, Wh</td>
    <td>Motor torque, heating element health, and parasitic drag.</td>
  </tr>
  <tr>
    <td><strong>4. Ground Truth</strong></td>
    <td>phase, machine_state, target_rpm, temp</td>
    <td>Categorical, RPM, &deg;C</td>
    <td>Contextual baseline conditioning to prevent false alarms.</td>
  </tr>
  <tr>
    <td><strong>5. Prognostics</strong></td>
    <td>parasitic_drag_w, machine_health_index</td>
    <td>W, % (0%–100%)</td>
    <td>Dynamic laundry mass, bearing health, and RUL forecast.</td>
  </tr>
</table>

<div class="page-break"></div>

<h1 class="section-header">6. Macro Township Infrastructure Scaling: Commercial Assets</h1>
<p>While proven on a front-load washing machine, the commercial value for Sime Darby Property lies in retrofitting commercial and communal rotating infrastructure:</p>

<table>
  <tr>
    <th>Township Asset Location</th>
    <th>Target Equipment</th>
    <th>Critical Failure Mode</th>
    <th>AcuVibe Solution</th>
  </tr>
  <tr>
    <td><strong>Masjid Elmina & Suraus</strong></td>
    <td>4–8 Central AC Chillers (15–30 kW)</td>
    <td>Compressor bearing fatigue & Friday prayer breakdown.</td>
    <td>Pre-emptive bearing swap during off-peak weekdays.</td>
  </tr>
  <tr>
    <td><strong>Elmina Lakeside Mall</strong></td>
    <td>15–30 Commercial Rooftop Chillers</td>
    <td>Parasitic motor drag; massive tenant electricity bills.</td>
    <td>Continuous parasitic wattage tracking & alert.</td>
  </tr>
  <tr>
    <td><strong>Community Clubhouses</strong></td>
    <td>4–6 Pool Booster Pumps & HVAC</td>
    <td>Impeller cavitation & dry-run damage.</td>
    <td>Acoustic cavitation RMS alert & auto-cutoff.</td>
  </tr>
  <tr>
    <td><strong>Township Water Stations</strong></td>
    <td>2–4 High-Head Drainage Pumps</td>
    <td>Pump seizure during heavy monsoon floods.</td>
    <td>Periodic vibration health testing prior to rains.</td>
  </tr>
</table>

<div class="callout green avoid-break">
  <div class="callout-title">Quantified Financial & Sustainability ROI (25 Commercial Assets)</div>
  <ul>
    <li><strong>Baseline Consumption:</strong> 20 kW &times; 10 hrs/day &times; 365 days = 73,000 kWh/year per compressor.</li>
    <li><strong>Parasitic Friction Drag (15%):</strong> 10,950 kWh/year wasted per degraded unit.</li>
    <li><strong>Financial Waste (TNB Tariff B @ RM 0.509/kWh):</strong> <strong>RM 5,573 wasted/year</strong> per degraded unit. Across 10 degraded compressors, that is <strong>&gt; RM 55,700 in wasted electricity annually</strong>.</li>
    <li><strong>Deployment Cost:</strong> 25 pods &times; RM 170 = RM 4,250. <strong>Payback period is under 1 month.</strong></li>
    <li><strong>Carbon Offset:</strong> <strong>75 metric tons of CO&sub2; equivalent avoided annually</strong> across 25 units.</li>
    <li><strong>Circular Economy:</strong> <strong>25 to 40 metric tons</strong> of compressor scrap metal and e-waste prevented.</li>
  </ul>
</div>

<h1 class="section-header">7. Implementation Roadmap for Sime Darby Property</h1>
<div class="diagram-box">
PHASE 1: MICRO TESTBED (COMPLETED & VERIFIED)
• Edge rig operational on Samsung washer; Dual-Core FreeRTOS C++ firmware running.
• 5,530+ verified operational points; Live Cloudflare dashboard at https://washer-pdm.pages.dev.
                                    &darr;
PHASE 2: TOWNSHIP PILOT DEPLOYMENT (MONTHS 1–3)
• Deploy 25 sensor pods across Masjid Elmina, Elmina Lakeside Mall, and Clubhouses.
• Establish baseline vibration and power profiles under commercial loads.
                                    &darr;
PHASE 3: PLATFORM & RESIDENT APP INTEGRATION (MONTHS 4–6)
• Centralized Facility Management Command Dashboard for Sime Darby Property FM teams.
• Integration with Sime Darby Township Resident App for home appliance health notifications.
                                    &darr;
PHASE 4: TOWNSHIP-WIDE STANDARDIZATION (MONTHS 7–12)
• Standard inclusion in future residential handovers across Bandar Bukit Raja and City of Elmina.
• Automated circular parts replacement and ESG sustainability reporting.
</div>

<div class="page-break"></div>

<!-- PART 2: RUBRIC SCORING BREAKDOWN -->
<h2 class="part-header">Part 2: Official Kolaxus 6-Axis Evaluation Rubric Breakdown</h2>

<table>
  <tr>
    <th style="width:25%;">Evaluation Axis</th>
    <th style="width:10%;">Weight</th>
    <th style="width:40%;">How AcuVibe PdM Achieves Maximum Score</th>
    <th style="width:25%;">Submission Evidence</th>
  </tr>
  <tr>
    <td><strong>1. Impact & Sustainability Value</strong></td>
    <td><strong>25%</strong></td>
    <td>Dual sustainability: eliminates 15%–35% parasitic electricity waste and extends asset lifespan by 5–10 years to prevent metric tons of e-waste.</td>
    <td>TNB tariff equations; Peninsular Malaysia grid emission factor (0.758 kg CO&sub2;/kWh).</td>
  </tr>
  <tr>
    <td><strong>2. Innovation & Differentiation</strong></td>
    <td><strong>20%</strong></td>
    <td>Novel multimodal fusion (50 Hz kinematics + 16 kHz DMA acoustics + 1 Hz power + SmartThings state). Phase-conditioned anomaly detection eliminates false alarms.</td>
    <td>31-column ML contract in <code>pdm_feature_dictionary.json</code>; FreeRTOS dual-core code.</td>
  </tr>
  <tr>
    <td><strong>3. Feasibility & Deliverability</strong></td>
    <td><strong>20%</strong></td>
    <td>Sub-RM 50 production BOM, non-intrusive clip-on magnetic/adhesive pods requiring zero rewiring, with automated Force-ON safety guards.</td>
    <td>Turnkey BOM under RM 171 (< RM 50 at volume); physical prototype rig, IP65 enclosure photos, and engineering cutaways.</td>
  </tr>
  <tr>
    <td><strong>4. Strategic Fit & Theme Relevance</strong></td>
    <td><strong>15%</strong></td>
    <td>Directly answers the "Township of Tomorrow" core brief (Value multiplying people, businesses, and planet). Anchored to City of Elmina assets.</td>
    <td>Site-specific rollout for Masjid Elmina, Lakeside Mall, and retention ponds.</td>
  </tr>
  <tr>
    <td><strong>5. Commercial & Value Multiplication</strong></td>
    <td><strong>10%</strong></td>
    <td>Scalable B2B SaaS and Facility Management model with an immediate payback period under 3 months for commercial buildings.</td>
    <td>RM 55,700 annual electricity waste eliminated against RM 4,250 hardware cost.</td>
  </tr>
  <tr>
    <td><strong>6. Team, Evidence & Pitch Quality</strong></td>
    <td><strong>10%</strong></td>
    <td><strong>Operating physical rig with working code</strong>, 5,530+ verified real data points, and active live deployed dashboard accessible worldwide.</td>
    <td>Live dashboard at <code>https://washer-pdm.pages.dev</code>; physical prototype photos; 6 real wash datasets.</td>
  </tr>
</table>

<!-- PART 3: PITCH DECK BLUEPRINT -->
<h2 class="part-header" style="margin-top:20px;">Part 3: The 8-Slide Grand Finale Pitch Deck Blueprint</h2>

<div class="slide-card">
  <div class="slide-header">
    <span class="slide-title">Slide 1: Cover & Vision &mdash; The Pulse of Sustainable Townships</span>
    <span class="slide-num">SLIDE 1 (30s)</span>
  </div>
  <p><strong>Visuals:</strong> High-tech split rendering: Physical IoT pod on left; township asset health dashboard on right. Live URL banner: <code>https://washer-pdm.pages.dev</code>.</p>
  <div class="script-box">
    "Judges, modern townships pride themselves on sustainability. Yet behind the scenes, hundreds of air-conditioning chillers, pumps, and household appliances run until they break down. We are AcuVibe, and we are introducing multimodal predictive maintenance to eliminate friction, save electricity, and keep machines out of landfills."
  </div>
</div>

<div class="slide-card">
  <div class="slide-header">
    <span class="slide-title">Slide 2: The Silent Crisis &mdash; Friction Leeching in Modern Townships</span>
    <span class="slide-num">SLIDE 2 (40s)</span>
  </div>
  <p><strong>Visuals:</strong> 3 waste callouts: Parasitic Drag (+15%–35% Watts), Catastrophic Breakdown (RM 25 fix vs RM 1,500+ motor burnout), and Landfill E-Waste.</p>
  <div class="script-box">
    "When a bearing loses lubrication, an inverter motor draws up to 35% excess electricity to overcome friction—undetected for months. When it finally locks up, a RM 25 component failure becomes a RM 1,500 motor replacement and 70 kg of landfill e-waste."
  </div>
</div>

<div class="slide-card">
  <div class="slide-header">
    <span class="slide-title">Slide 3: Universal Electromechanical Physics & The P-F Interval</span>
    <span class="slide-num">SLIDE 3 (40s)</span>
  </div>
  <p><strong>Visuals:</strong> P-F Curve diagram showing AcuVibe early detection at Point P vs traditional breakdown at Point F.</p>
  <div class="script-box">
    "Whether it is a 1,400 RPM washing machine or a 50 kW central chiller in Masjid Elmina, all rotating machinery fails identically: Micro-vibrations lead to acoustic friction, which causes parasitic electrical drag, and finally catastrophic breakdown. We catch it at Point P."
  </div>
</div>

<div class="page-break"></div>

<div class="slide-card">
  <div class="slide-header">
    <span class="slide-title">Slide 4: The AcuVibe Platform Architecture</span>
    <span class="slide-num">SLIDE 4 (45s)</span>
  </div>
  <p><strong>Visuals:</strong> Clean hardware diagram showing ESP32 Dual-Core separation, Tapo P110 power, and cloud pipeline.</p>
  <div class="script-box">
    "Our hardware costs under RM 50 in production. Using dual-core FreeRTOS processing, Core 1 handles 50 Hz vibration and 16 kHz audio without jitter, while Core 0 manages power monitoring and cloud sync. Our 31-feature ML contract conditions anomalies on machine state, eliminating false alarms."
  </div>
</div>

<div class="slide-card">
  <div class="slide-header">
    <span class="slide-title">Slide 5: The Working Prototype & Live Proof (Micro-Testbed)</span>
    <span class="slide-num">SLIDE 5 (45s)</span>
  </div>
  <p><strong>Visuals:</strong> The "Trio of Empirical Proof": (1) Photo of Physical IP65 Prototype Rig, (2) 3D Cutaway Installation Diagram, and (3) Live 4-Card Dashboard HUD at <code>https://washer-pdm.pages.dev</code>.</p>
  <div class="script-box">
    "Judges, most hackathon submissions remain hypothetical slides. We physically built our prototype and stress-tested it on an active 1,400 RPM Samsung washer. Why? Because a washing machine drum with shifting wet laundry is one of the most violent, acoustically noisy electromechanical systems in existence. We proved that our sub-RM 50 edge sensor pod captures, packages, and streams vibration, acoustics, and power in real time with zero false alarms. Having proven this in the toughest testbed, mass-producing these pods for stationary AC compressors at Masjid Elmina or Elmina Lakeside Mall is mechanically simpler, low-risk, and immediately viable."
  </div>
</div>

<div class="slide-card">
  <div class="slide-header">
    <span class="slide-title">Slide 6: Scaling to Macro Township Infrastructure</span>
    <span class="slide-num">SLIDE 6 (40s)</span>
  </div>
  <p><strong>Visuals:</strong> Map of City of Elmina showing 25 communal asset retrofits (Masjid Elmina, Lakeside Mall, Clubhouses).</p>
  <div class="script-box">
    "We are taking this from 1 washing machine to 25 commercial assets across City of Elmina. Facility managers get an automated health command center, while residents get transparent appliance health updates on the Sime Darby Resident App."
  </div>
</div>

<div class="slide-card">
  <div class="slide-header">
    <span class="slide-title">Slide 7: Measurable Sustainability & Financial ROI</span>
    <span class="slide-num">SLIDE 7 (30s)</span>
  </div>
  <p><strong>Visuals:</strong> Metrics card: RM 55,700/year electricity saved, &lt; 1 month payback, 75 tons CO&sub2; offset annually.</p>
  <div class="script-box">
    "Across 25 commercial chillers, eliminating 15% parasitic friction saves over 100,000 kWh and RM 55,000 annually. Against a hardware cost of RM 4,250, the capital payback is under one month, while cutting 75 tons of carbon emissions."
  </div>
</div>

<div class="slide-card">
  <div class="slide-header">
    <span class="slide-title">Slide 8: Township Pilot Roadmap & Future Vision</span>
    <span class="slide-num">SLIDE 8 (30s)</span>
  </div>
  <p><strong>Visuals:</strong> 3-phase timeline: Pilot (Months 1–3), Integration (Months 4–6), Standardization (Months 7–12).</p>
  <div class="script-box">
    "Sustainable townships start with smart, friction-free engineering. With AcuVibe, Sime Darby Property can lead Southeast Asia in circular, energy-efficient asset management. Thank you."
  </div>
</div>

<!-- PART 4: RAPID SUBMISSION PACK -->
<h2 class="part-header" style="margin-top:20px;">Part 4: Rapid Online Portal Submission Q&A Pack</h2>

<div class="callout avoid-break">
  <div class="callout-title">Q1: Problem Description (160 words)</div>
  <p>In modern sustainable townships, electromechanical equipment—from residential washing machines to central air conditioning compressors in community mosques and retail centers—is managed reactively. When bearings, seals, or dampers degrade, they create mechanical friction. Because modern inverter motors automatically draw excess electrical current to maintain speed, degraded machinery leeches <strong>15% to 35% excess electrical power</strong> for months without tripping circuit breakers.</p>
  <p>Eventually, unaddressed friction leads to total motor burnout or compressor seizure. A minor, unaddressed RM 25 component failure cascades into catastrophic hardware destruction (costing RM 800–RM 1,800+ for appliances and RM 15,000–RM 50,000+ for commercial chillers). This forces premature scrapping of 70 kg domestic machines and heavy commercial castings into landfills. In large developments, manual technician inspections miss early acoustic and kinematic anomalies, leaving township operators blind to mounting energy waste and sudden public service failures.</p>
</div>

<div class="callout avoid-break">
  <div class="callout-title">Q2: Innovation & Uniqueness (180 words)</div>
  <p>AcuVibe PdM is the first low-cost (&lt; RM 50 production BOM) multimodal edge-AI platform that fuses four synchronized physical dimensions: <strong>high-frequency 3-axis kinematics (&plusmn;16g @ 50 Hz)</strong>, <strong>ultrasonic/acoustic sound pressure (16 kHz 24-bit I2S DMA)</strong>, <strong>active electrical power (W, V, mA @ 1 Hz)</strong>, and <strong>ground-truth operational phase</strong>.</p>
  <p>Existing commercial predictive maintenance systems cost thousands of ringgit per sensor, target only heavy industrial oil-and-gas plants, and produce frequent false alarms during normal high-speed operations. AcuVibe solves this via <strong>phase-conditioned anomaly modeling</strong>: by conditioning vibration and sound against ground-truth operational states, our algorithm distinguishes between high-speed centrifugal dynamics and actual mechanical failure.</p>
  <p>Furthermore, our FreeRTOS dual-core firmware architecture isolates 50 Hz sensor sampling from network streaming, ensuring zero dropped audio samples and millisecond-level responsiveness. Combined with our automated Force-ON safety guard, AcuVibe delivers industrial-grade prognostics at a consumer-accessible price point.</p>
</div>

<div class="callout avoid-break">
  <div class="callout-title">Q3: Technical Implementation (185 words)</div>
  <p>The physical prototype utilizes an ESP32 dual-core microcontroller running custom C++ FreeRTOS firmware: <strong>Core 1</strong> executes uninterrupted 50 Hz MPU-6050 I2C burst reading and 16 kHz INMP441 digital I2S DMA buffer capture, wrapping data into a standardized JSON telemetry envelope guarded by <code>portMUX_TYPE</code> spinlocks. <strong>Core 0</strong> executes dual-tier streaming: a 1 Hz hot path pushing to Google Firebase <code>/live.json</code> for live dashboard rendering, and a 5.0s batch archival path for ML model training, while concurrently polling Tapo P110 active power via encrypted local KLAP protocol. Ground-truth machine state is integrated via Samsung SmartThings REST API.</p>
  <p>We overcame three critical technical hurdles: (1) Thread Starvation & Jitter solved by dual-core processor affinity and spinlock memory handoffs; (2) Spin Cycle False Alarms solved by a 31-feature ML prognostic contract conditioning vibration thresholds on ground-truth phase; (3) Smart Plug Safety solved by an automated background watchdog that detects accidental relay deactivation within 1,000ms and forces power back ON.</p>
  <p>The system is validated by over <strong>5,530 verified real operational data points</strong> and an active live web dashboard deployed at <code>https://washer-pdm.pages.dev</code>.</p>
</div>

<div class="callout avoid-break">
  <div class="callout-title">Q4: Target Audience & Adoption (175 words)</div>
  <p>AcuVibe serves two primary user tiers across Sime Darby Property developments: (1) <strong>Township Facility Managers (B2B)</strong> managing commercial assets across community mosques, suraus, retail malls (e.g., Elmina Lakeside Mall), and clubhouse facilities. Adoption is driven by out-of-the-box retrofitting: non-intrusive clip-on pods attach to existing compressor housings in under 10 minutes without rewiring, feeding directly into a unified township facility dashboard. (2) <strong>Township Residents (B2C)</strong> in smart residential precincts, reached through native integration with the <strong>Sime Darby Township Resident App</strong> with intuitive Machine Health Index notifications.</p>
  <p>To drive early adoption, Sime Darby Property can bundle AcuVibe sensor pods as a standard smart sustainability amenity in new home handovers, while piloting commercial compressor monitoring across flagship communal buildings to demonstrate immediate utility bill reductions.</p>
</div>

<div class="callout avoid-break">
  <div class="callout-title">Q5: Feasibility & Execution Roadmap (180 words)</div>
  <p>We have already completed Phase 1: a field-tested physical testbed on a Samsung front-load washer, dual-core FreeRTOS firmware, 5,530+ verified telemetry records, and a live cloud dashboard deployed on Cloudflare Pages.</p>
  <p>Our future execution roadmap comprises three structured phases: (1) <strong>Months 1–3 (Township Pilot):</strong> Retrofit 25 communal rotating assets in <strong>City of Elmina</strong> (8 central AC chillers in Masjid Elmina, 11 rooftop compressors at Elmina Lakeside Mall, and 6 clubhouse filtration pumps). Validate energy waste reductions in live commercial operating conditions. (2) <strong>Months 4–6 (Platform & App Integration):</strong> Integrate machine health telemetry into the Sime Darby Resident Mobile App and deploy automated maintenance triage ticketing for certified local service providers. (3) <strong>Months 7–12 (Township-Wide Scaling):</strong> Standardize AcuVibe pods as an optional sustainability add-on for new residential handovers across Bandar Bukit Raja and City of Elmina, establishing an automated circular economy parts-replacement network.</p>
</div>

</body>
</html>
"""

    with open(html_path, "w", encoding="utf-8") as f:
        f.write(html_content)
    print(f"HTML presentation written to: {html_path}")

    # Convert to PDF using Edge headless
    edge_path = r"C:\Program Files (x86)\Microsoft\Edge\Application\msedge.exe"
    if not os.path.exists(edge_path):
        edge_path = r"C:\Program Files\Microsoft\Edge\Application\msedge.exe"

    if os.path.exists(edge_path):
        cmd = [
            edge_path,
            "--headless=new",
            "--disable-gpu",
            "--no-pdf-header-footer",
            f"--print-to-pdf={pdf_path}",
            html_path
        ]
        print("Invoking Edge headless to generate PDF...")
        res = subprocess.run(cmd, capture_output=True, text=True)
        print(res.stdout)
        if os.path.exists(pdf_path):
            size_kb = os.path.getsize(pdf_path) / 1024.0
            print(f"SUCCESS: Generated PDF at {pdf_path} ({size_kb:.1f} KB)")
        else:
            print("ERROR: PDF was not generated by Edge headless.")
    else:
        print("Microsoft Edge executable not found.")

if __name__ == "__main__":
    main()
