adamdanishj30/washer-pdm/(commit log)

2026-10-11 feat: complete multimodal washing machine PdM rig, firmware, and real-time cloud dashboard
    [wash_1009.csv, wash_1019.csv, wash_1020.csv, wifi_test_log.csv]
2026-10-11 feat: redesign dashboard with modern mobile-friendly dark UI and full wash_1019 cycle projection
    [wash_1019.csv]
2026-10-11 fix: replace raw unicode bullets with CSS dots to fix mojibake encoding bug
    [build_clean_dashboard.py]
2026-10-11 fix: isolate canvas gutters to prevent waveform collisions and sync timeline metrics
    [build_clean_dashboard.py]
2026-10-11 fix(mobile): optimize layout, responsive gutters, eliminate text collisions on mobile
    [build_clean_dashboard.py]
2026-10-11 refactor(data): rename wash session files to date and time format for easier identification
    [wash_cycle_2026-10-11_1009.csv, wash_cycle_2026-10-11_1019.csv, wash_cycle_2026-10-11_1020.csv]
2026-10-11 fix(charts): dynamic anti-collision badge positioning and eliminate overlapping axis ticks
    [build_clean_dashboard.py]
2026-10-12 feat(dashboard): add dynamic session selector, custom CSV file loader, and cloud session discovery
    [wash_cycle_2026-10-11_1009.csv, wash_cycle_2026-10-11_1020.csv]
2026-10-12 feat: separate and load 12 Oct 8:00 AM wash session (1216 points, 103m) and add NTP time-sync to ESP32
    [wash_cycle_2026-10-12_0800.csv]
2026-10-12 feat(cloud): add offline auto-sync to drive pipeline and Tapo/SmartThings handoff
    [wash_cycle_2026-10-12_1009.csv, wash_cycle_2026-10-12_1019.csv, wash_cycle_2026-10-12_1020.csv]
2026-10-15 feat(dashboard): add electrical power & energy consumption diagnostics card with Tapo P110 integration
    [wash_cycle_1009.csv, wash_cycle_2026-10-12_0800.csv, wash_cycle_2026-10-15_1020.csv, wash_cycle_2026-10-15_live_snapshot.csv, wash_cycle_2026-10-15_morning.csv]
2026-10-15 fix(energy): add live Tapo Firebase listener and streamer bridge for real-time power display
2026-10-15 feat(safety): add automated Force-On watchdog guard against accidental button presses
2026-10-15 feat(data): add automated multimodal data capture engine and unified prediction dataset
    [pdm_multimodal_prediction_dataset.csv]
2026-10-15 feat(sync): upgrade cloud_downloader to capture power_w and auto-export sessions into data/
    [wash_cycle_2026-10-16_0123.csv, wash_cycle_2026-10-16_0127.csv]
2026-10-15 feat(telemetry): track 100% of Tapo P110 metrics including monthly kWh and relay state
    [pdm_multimodal_prediction_dataset.csv, wash_cycle_2026-10-12_0800.csv, wash_cycle_2026-10-16_0123.csv, wash_cycle_2026-10-16_0127.csv]
2026-10-15 feat(data): preserve newly downloaded cloud sessions in data directory
    [wash_cycle_2026-10-16_0123.csv, wash_cycle_2026-10-16_0127.csv]
2026-10-15 feat(telemetry): track all 11 SmartThings parameters from Table 1 in dataset and snapshot
    [pdm_multimodal_prediction_dataset.csv]
2026-10-15 refactor(data): separate real wash sessions and testing data into dedicated subdirectories
    [wash_cycle_1009.csv, wash_cycle_2026-10-11_1009.csv, wash_cycle_2026-10-11_1019.csv, wash_cycle_2026-10-11_1020.csv, wash_cycle_2026-10-12_0800.csv, wash_cycle_2026-10-12_1009.csv, wash_cycle_2026-10-12_1019.csv, wash_cycle_2026-10-12_1020.csv]
2026-10-15 fix(data): standardize all session CSVs to 6-column schema with power_w included
    [wash_cycle_1009.csv, wash_cycle_2026-10-11_1009.csv, wash_cycle_2026-10-11_1019.csv, wash_cycle_2026-10-11_1020.csv, wash_cycle_2026-10-12_0800.csv, wash_cycle_2026-10-12_1009.csv, wash_cycle_2026-10-12_1019.csv, wash_cycle_2026-10-12_1020.csv]
2026-10-15 docs(handoff): document Session 10 SmartThings audit, data segregation, and power standardization
2026-10-15 feat(sync): configure 1-minute (60s) SmartThings phase polling and rate-limit throttle
2026-10-16 fix(dashboard): resolve energy chart runtime crash and preserve 6-column power telemetry
    [wash_cycle_2026-10-16_0852.csv, wash_cycle_2026-10-16_0857.csv]
2026-10-16 fix(dashboard): resolve energy chart runtime crash, add real-power fallback, and synchronize standardized datasets
    [pdm_ml_standardized_training_dataset.csv, pdm_multimodal_prediction_dataset.csv, wash_cycle_2026-10-16_0123.csv, wash_cycle_2026-10-16_0127.csv, wash_cycle_2026-10-16_0852.csv, wash_cycle_2026-10-16_0857.csv]
2026-10-16 feat(proposal): add Sime Darby Hackathon proposal dossier, executive PDF, and relocate idle run to testing data
    [pdm_ml_standardized_training_dataset.csv, wash_cycle_2026-10-12_0800.csv]
2026-10-17 feat(proposal): add 2-page executive proposal PDF and synchronize canonical multimodal datasets
    [pdm_ml_standardized_training_dataset.csv, wash_cycle_2026-10-12_0800.csv, wash_cycle_2026-10-15_1020.csv, wash_cycle_2026-10-16_0123.csv, wash_cycle_2026-10-16_0127.csv, wash_cycle_2026-10-16_0857.csv]
2026-10-17 fix(pipeline): correct offline session routing to real_sessions and eliminate spurious none phase classifications
    [pdm_ml_standardized_training_dataset.csv, wash_cycle_1009.csv, wash_cycle_2026-10-12_0800.csv, wash_cycle_2026-10-15_1020.csv, wash_cycle_2026-10-16_0852.csv, wash_cycle_2026-10-16_0857.csv, wash_cycle_2026-10-17_0713.csv, wash_cycle_2026-10-17_0715.csv]
2026-10-17 fix(dashboard): completely remove cloud firebase sessions and fix 12 oct power data
    [wash_cycle_2026-10-17_0718.csv, wash_cycle_2026-10-17_0835.csv]
2026-10-17 perf(dashboard): isolate historical mode from network and throttle live polling to 5s
2026-10-18 fix(dashboard): accept 60 s idle heartbeat from firmware 07
    [build_clean_dashboard.py]
2026-10-18 feat(dashboard): add rolling trace, dynamic vib_std plotting, and adaptive sync
2026-10-19 fix(dashboard): restore cadence invariant, epoch time base, single buffer source, race guards, gap breaks
    [build_clean_dashboard.py]
2026-10-19 fix(dashboard): remove unsupported Card 4 claims; replace Spike with Idle/Running
    [build_clean_dashboard.py]
2026-10-19 feat(dashboard): plot firmware-07 vibration std and dominant frequency
    [build_clean_dashboard.py]
2026-10-20 fix(dashboard): read firmware-07 columns in Load CSV parser
    [build_clean_dashboard.py]
2026-10-21 feat(data): record wash programme context per session
    [session_context.csv]
2026-10-21 fix(data): reconcile session_context rows with real_sessions
    [session_context.csv]
2026-10-21 fix(ml): compute signature grouping and honest labels in cycle report
    [cycle_signature_report.py]
2026-10-21 fix: review notes (report wording, test isolation)
    [cycle_signature_report.py]
2026-10-21 fix(data): stop exporting guessed load_class; add load_kg to session context
    [session_context.csv]
2026-10-21 docs: plan writing guide track update
2026-10-21 docs: writing guide track (Energy Efficiency), sources, ML wording
2026-10-21 docs: proposal MPU rate and local fail-safe wording (approved by Adam)
    [generate_2page_pdf.py, generate_proposal_pdf.py]
2026-10-21 docs(handoff): complete writing guide track and sources update
2026-10-21 docs: current-state note (external edit)
2026-10-21 chore: track untracked source files (secrets-scanned)
2026-10-21 fix(deploy): commit preset_sessions.js and historical.html with dashboard pages
    [build_clean_dashboard.py]
2026-10-23 docs: rewrite README to match the submitted proposal
    Track is PLANET 03 Energy Efficiency only. Updates metrics and narrative to align with official hackathon submission guidelines.
2026-10-23 chore: trim repo to what the site, firmware, ML and submission need
    Removes superseded firmware sketches, legacy capture tools, hardware debug photos, old proposal drafts and generators, completed handoff plans, duplicate data snapshots and hackathon drafts. Adds submission/ with the final proposal and pitch deck PDFs. Updates README and CLAUDE.md to the new clean layout.
    [pdm_multimodal_prediction_dataset.csv, wash_cycle_2026-10-15_morning.csv]
2026-10-23 docs(submission): update pitch deck to agreed team version
2026-10-23 fix(data): move wash_cycle_2026-10-19_0022 to testing data calibration
    [wash_cycle_2026-10-19_0022.csv]
2026-10-31 feat(firmware): reset reason and manual test mode
    [07_feature_streamer.ino]
